TinyTapeout/tt-multiplexer/asw/ihp-sg13cmos5l/README.md

Tiny Tapeout Analog Switches for IHP SG13CMOS5L
===============================================

These are the analog switches that are used to connect/disconnect projects
from the analog pins.

* `tt_asw_3v3`: 3V3 rated switch
* `tt_ckt_ana`: Macro used to attach internal signals to analog pads

Design and layouts were done by Sylvain Munaut.
