TinyTapeout/tt-multiplexer/pg/ihp-sg13cmos5l/README.md

Tiny Tapeout Power Gates for IHP SG13CMOS5L
===========================================

* `tt_pg_1v5_hp_1`: Single height 1.5V switch (high-performance variant)
* `tt_pg_1v5_hp_2`: Dual   height 1.5V switch (high-performance variant)
* `tt_pg_1v5_hp_4`: Quad   height 1.5V switch (high-performance variant)
* `tt_pg_1v5_ll_1`: Single height 1.5V switch (low-leakage variant)
* `tt_pg_1v5_ll_2`: Dual   height 1.5V switch (low-leakage variant)
* `tt_pg_1v5_ll_4`: Quad   height 1.5V switch (low-leakage variant)
* `tt_pg_3v3_2`: Dual height 3.3V switch

Design and layouts were done by Sylvain Munaut.
