TinyTapeout/tt-multiplexer/(threads)

Thread 1 (2023-01-26):

controller / enable testing

jeremybirch, 2023-01-26:
As we have no manufacturing testing of these chips, particularly the user portion, it would be useful to at least be able to show that the enable shift chain is working as expected.
One simple way to do this would be to bring the end of the shift chain back out to a pad (during reset) so that we can see that if we shift N+1 times (where N is the number of user blocks) that the enable comes out at the right time. That we we would at least have some faith that the shift was working correctly, and would be able to characterise it, etc

smunaut, 2023-01-26:
There is no shift chain whatsoever ...

mattvenn, 2023-01-26:
I don't really understand the way designs are enabled: https://github.com/TinyTapeout/tt03-multiplexer/blob/9000062560129114836de59857dd23912760cbb5/proto/tt_ctrl.v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

smunaut, 2023-01-26:
It's an asynchronous counter.
Depending on the number of pulses, it counts up from 0 to 1023.
Then bit [9:5] are used to decode active row, and bit [4:0] to decode the active colum.
Decoding it done combinatorially.

jeremybirch, 2023-01-26:
Ok - sorry I thought it was shifting on the clock pulses. Any way we can
have visibility on the pins of it decoding so that we know at least that
bit is working?

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

jeremybirch, 2023-01-26:
Alternatively if it is counting pulses / why not just drive those row and
column components in from the pins and latch them on the trailing edge of
reset?!

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

smunaut, 2023-01-26:
This was discussed in the call.

Because then you need an external mux for 10 IO lines which is really annoying to deal with in a lot of cases depending on what you want to connect there.

An external uC can take care of sending the pulse with no problem.
Or if the caravel uC works, it can fulfill that function itself simply with 3 external straps ( and I took care to make an easy to strap pinout)

jeremybirch, 2023-01-27:
Ok how about use 1 extra pin and shift in the row and column bits ie takes
around 16 cycles rather than 200+ and eliminates the decode?

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

jeremybirch, 2023-01-27:
an advantage of this is that with  few extra bits in the shift chain you could also configure the IO’s for the given design (ie saying which of the bidirectional pins are configures to input/output/inout) rather than having that as a bus that has to run to every user design. Possibly less flexible than having each of the bidi pins individually configurable from every design on the fly, but I think a lot simpler and demands less wiring resource. Any other configuration specific to the design could also be done this way

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

WallieEverest, 2023-01-31:
Would someone confirm there are 37 MPRJ_IO pins to work with? It seems we have a few unexplored options. A simple solution would be best. We have student users.
Somewhat related topic: Which of the +1.8V power domains connect to our TT2 projects? VCCHIB, VCCD, VCCD1, or VCCD2? Can we isolate the RISC-V and/or the selection logic from the projects? Will the remaining chip work if user space is powered off?

mattvenn, 2023-02-03:
Yes, but as mentioned in the other issue, not all are easily usable.
Yes we're trying for simplicity and ensuring it works.
I can never remember the power domains, take a look at the caravel datasheet. We'll be using the first digital supply domain.

Closed 2023-05-29.

Thread 3 (2023-01-31):

Mux encoder on dev board

WallieEverest, 2023-01-31:
If we do decide on a serialized select method, perhaps we can implement an encoder into the development board?

(I still prefer a combinatorial selection. We just reduce user input size to io_in(10:0) )

mattvenn, 2023-02-03:
If caravel works, then we can use that to select designs and have a default / selection method.
If not then we'll have a co-processor that sits on the board and does the selection.

Closed 2023-05-29.

Thread 5 (2023-06-03):

PDN rails set manually

smunaut, 2023-06-03:
The formula for block / mux height is slightly off causing the planned rails to not fit.
Fixed manually for now, but :
(1) formula fix
(2) properly derive met5 rails params from config

(not done now because this would cause issue with block changing size for 3p5)

smunaut, 2023-07-26:
Fixed.

Closed 2023-07-26.

Thread 7 (2023-07-26):

Ensure no nets can float

smunaut, 2023-07-26:
We need fallback drivers in case no drivers are selected to prevent anything from floating. On both the H/V spines.

urish, 2023-07-26:
What happens if we don't address this?

urish, 2023-09-12:
Answer: when no design is selected, the state of the bidirectional / output pins is undefined.

urish, 2023-10-24:
Can we close this now?

Closed 2023-10-24.

Thread 14 (2024-11-07):

Schematic link for tt_asw_1v8 is wrong

FangameEmpire, 2024-11-07:
The schematic viewer URL points to
`https://github.com/TinyTapeout/tt-multiplexer/blob/main/tt_asw_1v8/xschem/tt_asw_1v8.sch`
when it should point to
`https://github.com/TinyTapeout/tt-multiplexer/blob/main/asw/tt_asw_1v8/xschem/tt_asw_1v8.sch`

The 3.3V version works though.

urish, 2024-11-07:
Thanks for reporting! where is it linked from?

FangameEmpire, 2024-11-15:
The link is at the top of https://github.com/TinyTapeout/tt-multiplexer/blob/main/asw/tt_asw_1v8/README.md

Closed 2024-12-09.
