TinyTapeout/tt-multiplexer/ol2/tt_top/odb_route.py

#
# OpenDB script for custom IO routing for tt_top / user_project_wrapper
#
# Copyright (c) 2023 Sylvain Munaut <tnt@246tNt.com>
# SPDX-License-Identifier: Apache-2.0
#

import os
import sys
import yaml
from collections import namedtuple

import odb

sys.path.append('../../py')
import tt
import tt_odb

import click

from reader import click_odb


def getOtherITermsOnNet(it):
	return [x for x in it.getNet().getITerms() if x.this != it.this]


def load_route_data(tti):
	fn = f'route_data_{tti.cfg.pdk.name}_{tti.cfg.pdk.die.width.nm:d}_{tti.cfg.pdk.die.height.nm:d}.yaml'
	return yaml.load(open(fn), yaml.FullLoader)


class Router:

	def __init__(self, reader, tti):
		# Save vars
		self.reader = reader
		self.tti    = tti

		# Find useful data
		tech = reader.db.getTech()

		self.layer_h = tech.findLayer('Metal3')
		self.layer_v = tech.findLayer('Metal4')
		self.via     = tech.findVia('Via3_XY')

		self.x_spine = []
		self.y_muxes = {}

	def route_vspine_net(self, net):
		# Find extents as well as Y mux pos and X spine pos
		x_min   = None
		x_max   = None

		y_min   = None
		y_max   = None

		x_spine = None
		y_mux   = dict()
		y_ctrl  = [None, None]

		for it in net.getITerms():
			# Get coordinates
			r, x, y = it.getAvgXY()
			if r is not True:
				continue

			# Collect the extent
			if (y_min is None) or (y < y_min):
				y_min = y

			if (y_max is None) or (y > y_max):
				y_max = y

			name = it.getInst().getName()
			if 'ctrl_I' in name:
				x_spine = x
				self.x_spine.append(x)
			else:
				y_mux.setdefault(y, []).append(x)
				self.y_muxes.setdefault(name, (x, []))[1].append(y)

		# Create wire and matching encoder
		wire = odb.dbWire.create(net)

		encoder = odb.dbWireEncoder()
		encoder.begin(wire)

		# Create vertical spine
		encoder.newPath(self.layer_v, 'FIXED')
		encoder.addPoint(x_spine, y_min)
		encoder.addPoint(x_spine, y_max)

		# Create horizontal link for each mux
		for y,xl in y_mux.items():
			xl.append(x_spine)
			x_min_l = min(xl)
			x_max_l = max(xl)

			encoder.newPath(self.layer_h, 'FIXED')
			if x_min_l < x_spine:
				encoder.addPoint(x_min_l, y)
			encoder.addPoint(x_spine, y)
			if x_max_l > x_spine:
				encoder.addPoint(x_max_l, y)

			encoder.newPath(self.layer_v, 'FIXED')
			encoder.addPoint(x_spine, y)
			encoder.addTechVia(self.via)

		encoder.end()

	def route_vspine(self):
		# Find controller
		ctrl_inst = self.reader.block.findInst('top_I.ctrl_I')

		# Route each spine net
		for i in range(self.tti.layout.vspine.iw):
			self.route_vspine_net(ctrl_inst.findITerm(f'spine_bot_iw[{i:d}]').getNet())
			self.route_vspine_net(ctrl_inst.findITerm(f'spine_top_iw[{i:d}]').getNet())

		for i in range(self.tti.layout.vspine.ow):
			self.route_vspine_net(ctrl_inst.findITerm(f'spine_bot_ow[{i:d}]').getNet())
			self.route_vspine_net(ctrl_inst.findITerm(f'spine_top_ow[{i:d}]').getNet())

	def create_spine_obs(self):
		# Find top/bottom
		y_min = min(sum([yl for xl,yl in self.y_muxes.values()], []))
		y_max = max(sum([yl for xl,yl in self.y_muxes.values()], []))

		# Create vspine obstruction
		x_min_spine = min(self.x_spine)
		x_max_spine = max(self.x_spine)

		odb.dbObstruction_create(self.reader.block,
			self.layer_v,
			x_min_spine, y_min,
			x_max_spine, y_max,
		)

		# Create horizontal link obstruction for each mux
		for k, v in self.y_muxes.items():
			x_min_hlink = min([v[0], x_min_spine])
			x_max_hlink = max([v[0], x_max_spine])
			y_min_hlink = min(v[1])
			y_max_hlink = max(v[1])

			odb.dbObstruction_create(self.reader.block,
				self.layer_h,
				x_min_hlink, y_min_hlink,
				x_max_hlink, y_max_hlink,
			)

	def create_macro_obs(self):
		# Get all layers
		tech = self.reader.db.getTech()

		layers = [
			tech.findLayer(ln)
				for ln in
					self.tti.cfg.pdk.tracks._cfg.keys()
		]

		# Iterate over all macros
		for inst in self.reader.instances:
			bb = inst.getBBox()
			for l in layers:
				odb.dbObstruction_create(self.reader.block,
					l,
					bb.xMin() + self.tti.layout.glb.margin.x,
					bb.yMin() + self.tti.layout.glb.margin.y,
					bb.xMax() - self.tti.layout.glb.margin.x,
					bb.yMax() - self.tti.layout.glb.margin.y,
				)

	def route_pad(self):
		# Vias
		tech = self.reader.db.getTech()
		via3yx = tech.findVia('Via3_YX')
		via3xy = tech.findVia('Via3_XY')

		# Find controller instance
		ctrl_inst = self.reader.block.findInst('top_I.ctrl_I')

		# Load data file
		data = load_route_data(self.tti)['ports']

		# Iterate through data file
		for port_name, rpts in data.items():
			# Starting point
			it = ctrl_inst.findITerm(port_name)
			sx, sy = it.getAvgXY()[1:]
			sl = it.getGeometries()[0][0]

			# Net / Wire
			net = it.getNet()
			wire = odb.dbWire.create(net)

			# Ending point
			it_other = getOtherITermsOnNet(it)[0]
			e_rect = [rect for ly, rect in it_other.getGeometries() if ly.getName() == 'Metal3'][0]
			ex = e_rect.xCenter()
			ey = e_rect.yCenter()

			# Prepare path
			if len(rpts) == 1:
				rpts = [
					( rpts[0], None ),
					( ex, via3yx ),
					( ey, None ),
				]

			elif len(rpts) == 2:
				rpts = [
					( rpts[0], via3xy ),
					( rpts[1], via3xy ),
					( ey, via3xy ),
					( ex, None ),
				]

			else:
				raise RuntimeError('Invalid path')

			# Encoder start
			encoder = odb.dbWireEncoder()
			encoder.begin(wire)

			encoder.newPath(sl, 'FIXED')
			encoder.addPoint(sx, sy)

			# Scan through routing points
			px = sx
			py = sy
			xy = True

			for pt, vt in rpts:
				# Next point
				if xy:
					py = pt
				else:
					px = pt

				encoder.addPoint(px, py)

				# Toggle routing direction
				xy ^= True

				# Add via
				if vt is not None:
					encoder.addTechVia(vt)

			# Encoder end
			encoder.end()

	def route_um_tieoffs(self):
		# Get track info
		# We route horizontally on Metal4, non-preferred direction ...
		track_cfg = self.tti.cfg.pdk.tracks.Metal4.y

		def track_align(v):
			return track_cfg.offset + ((v - track_cfg.offset) // track_cfg.pitch) * track_cfg.pitch

		# Scan all the muxes
		for inst in self.reader.instances:
			# Not a mux -> skip
			if inst.getMaster().getName() != 'tt_mux':
				continue

			# Instance bounding box
			inst_bbox = inst.getBBox()
			inst_y_mid = ( inst_bbox.yMin() + inst_bbox.yMax() ) // 2

			# Scan all um_k_zero[]
			for k0_it in inst.getITerms():
				# Not right port ?
				if not k0_it.getMTerm().getName().startswith('um_k_zero'):
					continue

				# Get net and check if there are anything to tie
				k0_net = k0_it.getNet()
				if k0_net.getITermCount() <= 1:
					continue

				# Get layer
				layer = k0_it.getMTerm().getMPins()[0].getGeometry()[0].getTechLayer()

				# Get strap Y position
				sy = k0_it.getAvgXY()[2]

				if sy > inst_y_mid:
					sy = track_align(inst_bbox.yMax() + track_cfg.width + track_cfg.pitch - 1)
				else:
					sy = track_align(inst_bbox.yMin() - track_cfg.width)

				# Start custom routing
				wire = odb.dbWire.create(k0_net)

				encoder = odb.dbWireEncoder()
				encoder.begin(wire)

				# Collect all ITerms positions
				it_pos = [ it.getAvgXY()[1:] for it in k0_net.getITerms() ]
				it_pos.sort()

				encoder.newPath(layer, 'FIXED')

				for n, (px, py) in enumerate(it_pos):
					if n == 0:
						encoder.addPoint(px, py)
						encoder.addPoint(px, sy)
						continue
					elif n > 1:
						encoder.newPath(j)
					j = encoder.addPoint(px, sy)
					encoder.addPoint(px, py)

				# End routing
				encoder.end()

	def route_um_signals(self):
		# Get via
		tech = self.reader.db.getTech()
		via = tech.findVia('Via4_YY')

		# Scan all the user modules
		for um_inst in self.reader.instances:
			# Is this a user module ?
			if not um_inst.getName().endswith('.tt_um_I'):
				continue

			# Find matching mux
			ena_net = um_inst.findITerm('ena').getNet()
			for it in ena_net.getITerms():
				if it.getInst().getMaster().getName() == 'tt_mux':
					mux_inst = it.getInst()
					break
			else:
				# WTF couln't find mux ...
				continue

			# Get Y coordinates we need to connect to/from
			mux_bbox = mux_inst.getBBox()
			um_bbox  = um_inst.getBBox()

			if mux_bbox.yMin() > um_bbox.yMax():
				y_um  = um_bbox.yMax()
				y_mux = mux_bbox.yMin()
			else:
				y_um  = um_bbox.yMin()
				y_mux = mux_bbox.yMax()

			# Scan every connection
			for um_it in um_inst.getITerms():
				# Get the net
				net = um_it.getNet()

				# We only care about signals going between user module and
				# the mux and nowhere else
				net_it_lst = net.getITerms()

				if len(net_it_lst) != 2:
					continue

				for it in net_it_lst:
					if it.getInst().getMaster().getName() == 'tt_mux':
						mux_it = it
						break
				else:
					continue

				# We get the x coordinate from the mux since it's the only
				# we can trust
				_, x, _ = mux_it.getAvgXY()

				# Get layer too
				layer_mux = mux_it.getMTerm().getMPins()[0].getGeometry()[0].getTechLayer()
				layer_um  =  um_it.getMTerm().getMPins()[0].getGeometry()[0].getTechLayer()

				# Route the wire
				wire = odb.dbWire.create(net)

				encoder = odb.dbWireEncoder()
				encoder.begin(wire)
				encoder.newPath(layer_mux, 'FIXED')
				encoder.addPoint(x, y_mux)

				if layer_mux.getName() != layer_um.getName():
					encoder.addPoint(x, (y_mux + y_um) // 2)
					encoder.addTechVia(via)

				encoder.addPoint(x, y_um)
				encoder.end()


	def k01_get_track(self, side, idx):
		# Get full die area
		die = self.reader.block.getDieArea()

		# Prepare recording of used tracks if not done already
		if not hasattr(self, 'k01_tracks'):
			self.k01_tracks = {
				'left':  [],
				'right': [],
				'bot':   [],
				'top':   [],
			}

		# Track config
		cfg_tv = self.tti.cfg.pdk.tracks.met4.x
		cfg_th = self.tti.cfg.pdk.tracks.met3.y

		# Alignement function
		def a(cfg, v):
			return cfg.offset + ((v - cfg.offset) // cfg.pitch) * cfg.pitch

		# Return requested track
		if side == 'left':
			t = cfg_tv.offset + cfg_tv.pitch * idx

		elif side == 'right':
			t = a(cfg_tv, die.xMax() - cfg_tv.pitch * idx)

		elif side == 'bot':
			t = cfg_th.offset + cfg_th.pitch * idx

		elif side == 'top':
			t = a(cfg_th, die.yMax() - cfg_th.pitch * idx)

		else:
			# ?!!?
			t = None

		self.k01_tracks[side].append(t)
		return t;

	def route_k01_gpio(self):
		# Get full die area
		die = self.reader.block.getDieArea()

		# Vias
		tech = self.reader.db.getTech()

		via = {
			('met2', 'met3'): tech.findVia('M2M3_PR'),
			('met3', 'met4'): tech.findVia('M3M4_PR'),
		}

		# Scan all BTerm to find gpio_loopback_{zero,one}[]
		for bterm in self.reader.block.getBTerms():
			# Check it's a bterm of interest
			if not bterm.getName().startswith('gpio_loopback'):
				continue

			# Select index
			if 'zero' in bterm.getName():
				idx = 0
			elif 'one' in bterm.getName():
				idx = 1

			# Select side
			bt_bbox = bterm.getBBox()
			if   bt_bbox.xMin() < die.xMin():
				side = 'left'
			elif bt_bbox.xMax() > die.xMax():
				side = 'right'
			elif bt_bbox.yMin() < die.yMin():
				side = 'bot'
			elif bt_bbox.yMax() > die.yMax():
				side = 'top'

			# Get track
			trk = self.k01_get_track(side, idx)

			# Get layer of bterm
			bterm_box = bterm.getBPins()[0].getBoxes()[0]
			bterm_ly  = bterm_box.getTechLayer()

			# Get the coordinates for all other bterms on net
			net = bterm.getNet()

			pos = []

			for bterm_sec in net.getBTerms():
				# Check it's in the same layer
				if bterm_sec.getBPins()[0].getBoxes()[0].getTechLayer().getName() != bterm_ly.getName():
					continue

				# Get position
				pr, px, py = bterm_sec.getFirstPinLocation()
				if pr is not True:
					continue

				# Record it
				pos.append( (px, py) )

			# Create new wire
			wire = odb.dbWire.create(net)

			# Encoder start
			encoder = odb.dbWireEncoder()
			encoder.begin(wire)

			# Draw
			if side in ['left', 'right']:
				# Vertical segment
				encoder.newPath(self.layer_v, 'FIXED')
				encoder.addPoint(trk, min([p[1] for p in pos]))
				encoder.addPoint(trk, max([p[1] for p in pos]))

				# Connect each position
				for px, py in pos:
					encoder.newPath(bterm_ly, 'FIXED')
					encoder.addPoint(px, py)
					encoder.addPoint(trk, py)
					encoder.addTechVia(via[(bterm_ly.getName(), self.layer_v.getName())])

			elif side in ['bot', 'top']:
				# Horizontal segment
				encoder.newPath(self.layer_h, 'FIXED')
				encoder.addPoint(min([p[0] for p in pos]), trk)
				encoder.addPoint(max([p[0] for p in pos]), trk)

				# Connect each position
				for px, py in pos:
					encoder.newPath(bterm_ly, 'FIXED')
					encoder.addPoint(px, py)
					encoder.addPoint(px, trk)
					encoder.addTechVia(via[(bterm_ly.getName(), self.layer_h.getName())])

			# Encoder end
			encoder.end()

	def route_k01_global(self):
		# Vias
		tech = self.reader.db.getTech()

		via = {
			('met2', 'met3'): tech.findVia('M2M3_PR'),
			('met3', 'met4'): tech.findVia('M3M4_PR'),
		}

		# Get full die area
		die = self.reader.block.getDieArea()

		# Find controller instance
		ctrl_inst = self.reader.block.findInst('top_I.ctrl_I')

		# Start index
		idx = 2

		# Deal with each constant
		for port_name in ['k_zero', 'k_one']:
			# ITerm on controller
			ctrl_iterm = ctrl_inst.findITerm(port_name)
			r, x, y = ctrl_iterm.getAvgXY()
			if r is not True:
				continue

			# Get associated net
			net = ctrl_iterm.getNet()

			# Check if there are any users
			if (net is None) or (len(net.getBTerms()) == 0):
				continue

			# Limits
			lx = [
				self.k01_get_track('left', idx),
				self.k01_get_track('right', idx),
			]

			ly = [
				self.k01_get_track('bot', idx),
				self.k01_get_track('top', idx),
			]

			idx += 1

			# Create new wire
			wire = odb.dbWire.create(net)

			# Encoder start
			encoder = odb.dbWireEncoder()
			encoder.begin(wire)

			# Line toward bottom
			encoder.newPath(self.layer_v, 'FIXED')
			encoder.addPoint(x, y)
			encoder.addPoint(x, ly[0])
			encoder.addTechVia(self.via)
			encoder.addPoint(lx[1], ly[0])
			encoder.addTechVia(self.via)
			encoder.addPoint(lx[1], ly[1])
			encoder.addTechVia(self.via)
			encoder.addPoint(lx[0], ly[1])
			encoder.addTechVia(self.via)
			encoder.addPoint(lx[0], ly[0])
			encoder.addTechVia(self.via)
			encoder.addPoint(x, ly[0])

			# Iterate over all BTerms
			for pad_bterm in net.getBTerms():
				# Get pin location / Bounding Box
				pr, px, py = pad_bterm.getFirstPinLocation()
				if pr is not True:
					continue

				pad_bb  = pad_bterm.getBBox()
				pad_box = pad_bterm.getBPins()[0].getBoxes()[0]
				pad_ly  = pad_box.getTechLayer()

				# Start path
				encoder.newPath(pad_ly, 'FIXED')
				encoder.addPoint(px, py)

				# Check side
				if pad_bb.yMin() < 0:				# Bottom
					encoder.addPoint(px, ly[0])
					encoder.addTechVia(via[(pad_ly.getName(), self.layer_h.getName())])

				elif pad_bb.yMax() > die.yMax():	# Top
					encoder.addPoint(px, ly[1])
					encoder.addTechVia(via[(pad_ly.getName(), self.layer_h.getName())])

				elif pad_bb.xMin() < 0:				# Left
					encoder.addPoint(lx[0], py)
					encoder.addTechVia(via[(pad_ly.getName(), self.layer_v.getName())])

				elif pad_bb.xMax() > die.xMax():	# Right
					encoder.addPoint(lx[1], py)
					encoder.addTechVia(via[(pad_ly.getName(), self.layer_v.getName())])

				else:
					# ?!?!?
					continue

			# Encoder end
			encoder.end()

	def create_k01_obs(self):

		# No tracks ?
		if not hasattr(self, 'k01_tracks'):
			return

		# Get all layers and config
		tech = self.reader.db.getTech()

		layer_v = tech.findLayer('met4')
		layer_h = tech.findLayer('met3')

		cfg_v = self.tti.cfg.pdk.tracks.met4.x
		cfg_h = self.tti.cfg.pdk.tracks.met3.y

		die = self.reader.block.getDieArea()

		# Limits
		if self.k01_tracks['left']:
			lx_left = [
				min(self.k01_tracks['left']) - cfg_v.pitch // 2,
				max(self.k01_tracks['left']) + cfg_v.pitch // 2,
			]
		else:
			lx_left = [ die.xMin(), die.xMin() ]

		if self.k01_tracks['right']:
			lx_right = [
				min(self.k01_tracks['right']) - cfg_v.pitch // 2,
				max(self.k01_tracks['right']) + cfg_v.pitch // 2,
			]
		else:
			lx_right = [ die.xMax(), die.xMax() ]

		if self.k01_tracks['bot']:
			ly_bot = [
				min(self.k01_tracks['bot']) - cfg_h.pitch // 2,
				max(self.k01_tracks['bot']) + cfg_h.pitch // 2,
			]
		else:
			ly_bot = [ die.yMin(), die.yMin() ]

		if self.k01_tracks['top']:
			ly_top = [
				min(self.k01_tracks['top']) - cfg_h.pitch // 2,
				max(self.k01_tracks['top']) + cfg_h.pitch // 2,
			]
		else:
			ly_top = [ die.yMax(), die.yMax() ]

		# Left
		if self.k01_tracks['left']:
			odb.dbObstruction_create(self.reader.block,
				layer_v, lx_left[0], ly_bot[0], lx_left[1], ly_top[1])

		# Right
		if self.k01_tracks['right']:
			odb.dbObstruction_create(self.reader.block,
				layer_v, lx_right[0], ly_bot[0], lx_right[1], ly_top[1])

		# Bottom
		if self.k01_tracks['bot']:
			odb.dbObstruction_create(self.reader.block,
				layer_h, lx_left[0], ly_bot[0], lx_right[1], ly_bot[1])

		# Top
		if self.k01_tracks['top']:
			odb.dbObstruction_create(self.reader.block,
				layer_h, lx_left[0], ly_top[0], lx_right[1], ly_top[1])



class ViaGenerator:

	def __init__(self, reader, via_rule_name):
		# No known via
		self.vias = {}

		# Save interesting vars
		self.reader = reader
		self.tech = tech = reader.db.getTech()

		# Find Via Rule
		self.via_rule = tech.findViaGenerateRule(via_rule_name)

		# Identify rules for top/cut/bot
		met = []

		for i in range(self.via_rule.getViaLayerRuleCount()):
			ly_rule = self.via_rule.getViaLayerRule(i)
			ly = ly_rule.getLayer()

			# Is it the cut ?
			if ly.getType() == 'CUT':
				self.cut_ly  = ly
				self.cut_sz  = [ ly_rule.getRect().dx(), ly_rule.getRect().dy() ]
				self.cut_spc = ly_rule.getSpacing()

				# The cut spacing in the rule is center to center
				# but when creating the via we need it border to border ?!?!
				self.cut_spc[0] -= self.cut_sz[0]
				self.cut_spc[1] -= self.cut_sz[1]

			# Or Metal ?
			elif ly.getType() == 'ROUTING':
				enc = ly_rule.getEnclosure()
				met.append( (ly.getName(), ly, enc) )

			# WTF ?
			else:
				raise RuntimeError('Unknown via rule')

		met = sorted(met)

		self.bot_ly  = met[0][1]
		self.bot_enc = met[0][2]

		self.top_ly  = met[1][1]
		self.top_enc = met[1][2]

	def create(self, ncols, nrows, name=None):
		# Create via
		if name is None:
			name = f'vg_{(hash(self) & 0xffffffff):08x}_{ncols:d}x{nrows:d}'

		v = odb.dbVia.create(self.reader.block, name)
		v.setViaGenerateRule(self.via_rule)

		# Configure params
		vp = v.getViaParams()

		vp.setBottomLayer(self.bot_ly)
		vp.setCutLayer(self.cut_ly)
		vp.setTopLayer(self.top_ly)
		vp.setNumCutCols(ncols)
		vp.setNumCutRows(nrows)
		vp.setXCutSize(self.cut_sz[0])
		vp.setYCutSize(self.cut_sz[1])
		vp.setXCutSpacing(self.cut_spc[0])
		vp.setYCutSpacing(self.cut_spc[1])
		vp.setXBottomEnclosure(self.bot_enc[0])
		vp.setYBottomEnclosure(self.bot_enc[1])
		vp.setXTopEnclosure(self.top_enc[0])
		vp.setYTopEnclosure(self.top_enc[1])

		v.setViaParams(vp)

		# Done
		return v

	def get(self, ncols, nrows):
		k = (ncols, nrows)
		if k not in self.vias:
			self.vias[k] = self.create(ncols, nrows)
		return self.vias[k]

	def get4sz(self, vw, vh):
		# Compute row / columns
		ncols = (vw // (self.cut_sz[0] + self.cut_spc[0])) - 1
		nrows = (vh // (self.cut_sz[1] + self.cut_spc[1])) - 1
		return self.get(ncols, nrows)

	def get4sz_ext(self, vw, vh, bot_fit='xy', top_fit='xy'):
		# Constraints
		ncols = []
		nrows = []

		if 'x' in bot_fit:
			ncols.append( (vw - 2 * self.bot_enc[0] + self.cut_spc[0]) // (self.cut_sz[0] + self.cut_spc[0]) )

		if 'x' in top_fit:
			ncols.append( (vw - 2 * self.top_enc[0] + self.cut_spc[0]) // (self.cut_sz[0] + self.cut_spc[0]) )

		if 'y' in bot_fit:
			nrows.append( (vh - 2 * self.bot_enc[1] + self.cut_spc[1]) // (self.cut_sz[1] + self.cut_spc[1]) )

		if 'y' in top_fit:
			nrows.append( (vh - 2 * self.top_enc[1] + self.cut_spc[1]) // (self.cut_sz[1] + self.cut_spc[1]) )

		ncols = min(ncols)
		nrows = min(nrows)

		# Safety check
		if (ncols <= 0) or (nrows <= 0):
			return None

		# Get final via
		return self.get(ncols, nrows)



class ModulePowerPadData(namedtuple('ModulePowerPadData', 'xc xw yb yt')):

	__slots__ = []

	@classmethod
	def from_geometry(kls, g, grid=1):
		xc = ((g.xMin() + g.xMax()) // (2 * grid)) * grid
		xw = min(g.xMax() - xc, xc - g.xMin()) * 2
		return kls(xc, xw, g.yMin(), g.yMax())


class ModulePowerStrapper:

	def __init__(self, reader, tti):
		# Save vars
		self.reader = reader
		self.tti    = tti

		# Find useful data
		tech = reader.db.getTech()

		self.vg = ViaGenerator(self.reader, 'viaTop1Array')
		self.layer = tech.findLayer('TopMetal1')

		self.stripe_space, self.stripe_width = self._find_stripe_space_width()
		self.space = 3000
		self.grid = tech.getManufacturingGrid()

	def _grid_align(self, v):
		return (v // self.grid) * self.grid

	def _find_stripe_space_width(self):
		# Get all `met5` stripes for VGND
		net = self.reader.block.findNet('vgnd')
		sw = net.getSWires()[0]
		stripes = [
			w for w in sw.getWires() if (
				not w.isVia() and
				w.getTechLayer().getName() == 'TopMetal1' and
				w.getWireShapeType() == 'STRIPE'
			)
		]

		# Get spacing and width
		yl = sorted([x.yMin() for x in stripes])

		return (yl[1] - yl[0]), stripes[0].getDY()

	def _get_y_pos_width(self, pg_inst, pg_idx, pg_cnt):
		# Is it single or double height ?
		h = int(pg_inst.getMaster().getName()[-1])

		# Get switch physical dimensions
		bbox = pg_inst.getBBox()

		y_min = bbox.yMin()
		y_max = bbox.yMax()
		y_mid = (y_min + y_max) // 2

		# If we only have one power strap, allocate all to it
		if pg_cnt == 1:
			# Wide strip
			w = 2 * self.stripe_width + self.space

			# Select depending on height
			if h == 1:
				return [ ( y_mid, w ) ]

			elif h == 2:
				return [
					( y_mid + self.stripe_space, w ),
					( y_mid,                     w ),
					( y_mid - self.stripe_space, w ),
				]

			elif h == 4:
				spc = self.stripe_space // 2
				return [
					( y_mid + spc * 7, w ),
					( y_mid + spc * 5, w ),
					( y_mid + spc * 3, w ),
					( y_mid + spc * 1, w ),
					( y_mid - spc * 1, w ),
					( y_mid - spc * 3, w ),
					( y_mid - spc * 5, w ),
					( y_mid - spc * 7, w ),
				]

			else:
				raise RuntimeError('Unsupported heigh Power Gate')

		# If we have two, then the center one is split
		elif pg_cnt == 2:
			# Wide and narrow stripes + offset
			ww = 2 * self.stripe_width + self.space
			wn = self.stripe_width

			ofs1 = (1 - 2*pg_idx) * ((self.stripe_width + self.space) // 2)
			ofs2 = (2*pg_idx - 1) * self.stripe_space

			# Select depending on height
			if h == 1:
				return [ ( y_mid + ofs1, wn ) ]

			elif h == 2:
				return [
					( y_mid + ofs1, wn ),
					( y_mid + ofs2, ww ),
				]

			else:
				raise RuntimeError('Unsupported heigh Power Gate')

		# Huh ?
		else:
			raise RuntimeError('Unsupported number of Power Gates')


	def _get_pad_data(self, um_it, pg_it):
		# Find geometry for those terminals
		geom_um = [ x[1] for x in pg_it.getGeometries() ]
		geom_pg = [ x[1] for x in um_it.getGeometries() ]
		geom = geom_um + geom_pg

		# Extent ( + extra for worse case enclosure requirement )
		xl = min([x.xMin() for x in geom]) - self.vg.top_enc[0]
		xr = max([x.xMax() for x in geom]) + self.vg.top_enc[0]

		# Center positions and width
		pd = [ModulePowerPadData.from_geometry(g, grid=self.grid) for g in geom]

		# Attempt to merge contiguous pads
		pd.sort(key=lambda x: (x.xc, x.yb))

		pd_merged = []
		pad_cur = pd[0]

		for pad_nxt in pd[1:]:
			if pad_cur.xc == pad_nxt.xc and pad_cur.xw == pad_nxt.xw and pad_cur.yt >= pad_nxt.yb:
				# Merge
				pad_cur = ModulePowerPadData(pad_cur.xc, pad_cur.xw, pad_cur.yb, max(pad_cur.yt, pad_nxt.yt))
			else:
				# Discontinuous
				pd_merged.append(pad_cur)
				pad_cur = pad_nxt

		pd_merged.append(pad_cur)

		# Return result
		return xl, xr, pd_merged

	def _draw_stripe(self, sw, yp, yw, xl, xr, pd):
		# Stripe
		odb.createSBoxes(sw, self.layer, [odb.Rect(xl, yp-yw//2, xr, yp+yw//2)], "STRIPE")

		# Vias
		for pad in pd:
			# Default via param
			vx = pad.xc
			vy = yp
			vw = pad.xw
			vh = yw
			bot_fit = 'x'

			# Validate extent of pad (with ample argin for enclosure)
			if ((yp - yw * 0.55) < pad.yb) or ((yp + yw * 0.55) > pad.yt):
				# Doesn't fully fit, so be more restrictive
				bot_fit = 'xy'

				y_bot = max(pad.yb, yp - yw // 2)
				y_top = min(pad.yt, yp + yw // 2)

				vy = self._grid_align((y_top + y_bot) // 2)
				vh = min(y_top - vy, vy - y_bot) * 2

			# Get matching via
			via = self.vg.get4sz_ext(vw, vh, top_fit='y', bot_fit=bot_fit)
			if via is None:
				continue

			# Add it
			odb.createSBoxes(sw, via, [odb.Point(vx, vy)], "STRIPE")

	def run(self):

		# Find all user modules
		for um_inst in self.reader.block.getInsts():
			# Is it a user module ?
			if not um_inst.getName().endswith('.tt_um_I'):
				continue

			# Find power ITerms with power gate
			pg_list = []

			for um_it in um_inst.getITerms():
				# Power ?
				if not um_it.getSigType() == 'POWER':
					continue

				# Check if it's on a power gate
				if um_it.getNet().getITermCount() != 2:
					continue

				pg_it = getOtherITermsOnNet(um_it)[0]

				# Record
				pg_list.append( (um_it, pg_it) )

			# Connect each
			pg_cnt = len(pg_list)

			for pg_idx, (um_it, pg_it) in enumerate(pg_list):
				# Power gate instance
				pg_inst = pg_it.getInst()

				# Pick appropriate Y positions for straps
				ypw = self._get_y_pos_width(pg_inst, pg_idx, pg_cnt)

				# Get the X data (extent + via pos)
				xl, xr, pd = self._get_pad_data(um_it, pg_it)

				# Find net and create the matching special wire
				net = um_it.getNet()
				sw = odb.dbSWire.create(net, "ROUTED")

				# Draw for each y position
				for yp, yw in ypw:
					self._draw_stripe(sw, yp, yw, xl, xr, pd)


class RingPowerStrapper:

	def __init__(self, reader):
		# Save vars
		self.reader = reader

		# Find useful data
		self.tech = tech = reader.db.getTech()

		self.layers = {
			2: tech.findLayer('Metal2'),
			3: tech.findLayer('Metal3'),
			4: tech.findLayer('Metal4'),
		}
		self.viagen = {
			(2,3): ViaGenerator(reader, 'via2Array'),
			(3,4): ViaGenerator(reader, 'via3Array'),
		}

	def find_ring_for_net(self, net):
		# Find all the boxes on met4
		boxes = []
		for sw in net.getSWires():
			for w in sw.getWires():
				# Skip vias
				if w.isVia():
					continue

				# Only ring
				if w.getWireShapeType() != 'RING':
					continue

				boxes.append(w)

		# There should be none or 4
		if len(boxes) == 0:
			return None

		if len(boxes) != 4:
			raise RuntimeError(f'Unexpected boxes for net {net.getName():s}')

		# Sort and return
		boxes_ver = sorted([b for b in boxes if b.getDX() < b.getDY()], key=lambda x:x.xMin())
		boxes_hor = sorted([b for b in boxes if b.getDX() > b.getDY()], key=lambda x:x.yMin())

		return {
			'l': boxes_ver[0],
			'r': boxes_ver[1],
			'b': boxes_hor[0],
			't': boxes_hor[1],
		}

	def complete_ring(self, net, ring):
		sw = odb.dbSWire.create(net, "ROUTED")
		for box in [ ring['b'], ring['t'] ]:
			odb.createSBoxes(sw, self.tech.findLayer('Metal4'), [odb.Rect(box.xMin(), box.yMin(), box.xMax(), box.yMax())], "RING")

	def strap_draw_lr(self, sw, sxl, sxr, rxl, rxr, yb, yt):
		# Metal2 Stripe
		odb.createSBoxes(sw, self.layers[2], [odb.Rect(sxl, yb, sxr, yt)], "STRIPE")

		# Metal3 "Intermediate"
		odb.createSBoxes(sw, self.layers[3], [odb.Rect(rxl, yb, rxr, yt)], "STRIPE")

		# Connecting vias
		via23 = self.viagen[(2,3)].get4sz(rxr-rxl, yt-yb)
		via34 = self.viagen[(3,4)].get4sz(rxr-rxl, yt-yb)

		rxm = (rxl + rxr) // 2
		ym  = ( yb +  yt) // 2
		odb.createSBoxes(sw, via23, [odb.Point(rxm, ym)], "STRIPE")
		odb.createSBoxes(sw, via34, [odb.Point(rxm, ym)], "STRIPE")

	def strap_draw_tb(self, sw, xl, xr, syb, syt, ryb, ryt):
		# Metal2 Stripe
		odb.createSBoxes(sw, self.layers[2], [odb.Rect(xl, syb, xr, syt)], "STRIPE")

		# Metal3 "Intermediate"
		odb.createSBoxes(sw, self.layers[3], [odb.Rect(xl, ryb, xr, ryt)], "STRIPE")

		# Connecting vias
		via23 = self.viagen[(2,3)].get4sz(xr-xl, ryt-ryb)
		via34 = self.viagen[(3,4)].get4sz(xr-xl, ryt-ryb)

		xm  = ( xl +  xr) // 2
		rym = (ryb + ryt) // 2
		odb.createSBoxes(sw, via23, [odb.Point(xm, rym)], "STRIPE")
		odb.createSBoxes(sw, via34, [odb.Point(xm, rym)], "STRIPE")

	def strap_iterm(self, net, ring, sw, iterm):
		# Core area
		core = self.reader.block.getCoreArea()

		# Scan all the geometries for that ITerm
		for ly, rect in iterm.getGeometries():
			# All power pins connections are expected to be on Metal2
			if ly.getName() != 'Metal2':
				continue

			# Get instance bbox
			ibb = iterm.getInst().getBBox()

			# Which side is the pin on ?
			if rect.xMax() < core.xMin():		# Left
				# Check geometry is on right side of the pad
				if ibb.xMax() != rect.xMax():
					continue

				# Create new SWire for our straps if needed
				if sw is None:
					sw = odb.dbSWire.create(net, "ROUTED")

				# Draw strap
				self.strap_draw_lr(sw,
					rect.xMax(),      ring['l'].xMax(),
					ring['l'].xMin(), ring['l'].xMax(),
					rect.yMin(),      rect.yMax()
				)

			elif rect.xMin() > core.xMax():		# Right
				# Check geometry is on left side of the pad
				if ibb.xMin() != rect.xMin():
					continue

				# Create new SWire for our straps if needed
				if sw is None:
					sw = odb.dbSWire.create(net, "ROUTED")

				# Draw strap
				self.strap_draw_lr(sw,
					ring['r'].xMin(), rect.xMin(),
					ring['r'].xMin(), ring['r'].xMax(),
					rect.yMin(),      rect.yMax()
				)

			elif rect.yMax() < core.yMin():		# Bottom
				# Check geometry is on top side of the pad
				if ibb.yMax() != rect.yMax():
					continue

				# Create new SWire for our straps if needed
				if sw is None:
					sw = odb.dbSWire.create(net, "ROUTED")

				# Draw strap
				self.strap_draw_tb(sw,
					rect.xMin(),      rect.xMax(),
					rect.yMax(),      ring['b'].yMax(),
					ring['b'].yMin(), ring['b'].yMax(),
				)

			elif rect.yMin() > core.yMax():		# Top
				# Check geometry is on bottom side of the pad
				if ibb.yMin() != rect.yMin():
					continue

				# Create new SWire for our straps if needed
				if sw is None:
					sw = odb.dbSWire.create(net, "ROUTED")

				# Draw strap
				self.strap_draw_tb(sw,
					rect.xMin(),      rect.xMax(),
					ring['t'].yMin(), rect.yMin(),
					ring['t'].yMin(), ring['t'].yMax(),
				)

			else:
				# ???
				continue

		return sw

	def strap_net(self, net):
		# Find all the rings boxes
		ring = self.find_ring_for_net(net)
		if ring is None:
			return

		# Complete the ring with Metal4 on top/bottom
		#self.complete_ring(net, ring)

		# Don't create SWire if not needed
		sw = None

		# Find all the ITerms
		for iterm in net.getITerms():
			# Check it's a pad
			if not iterm.getInst().getName().endswith('.pad_I'):
				continue
			if not iterm.getInst().getName().startswith('gpio'):
				continue

			# Connect it
			sw = self.strap_iterm(net, ring, sw, iterm)

	def run(self):
		# Scan all power nets and check if they need strapping
		for net in self.reader.block.getNets():
			if net.getSigType() in ['POWER', 'GROUND']:
				self.strap_net(net)


class AnalogRouter:

	def __init__(self, reader, tti):
		# Save vars
		self.reader = reader
		self.tti    = tti

		# Create tech rules
		self.prepare_tech()

		# Find all analog switches
		self.asw = [
			inst
				for inst in self.reader.block.getInsts()
				if inst.getMaster().getName().startswith('tt_asw')
		]

		# Load route data file
		self.route_data = load_route_data(tti).get('analog', {})

	def prepare_tech(self):
		# Find tech and layers
		tech = self.reader.db.getTech()
		self.layer_bot = tech.findLayer('Metal3')
		self.layer_top = tech.findLayer('Metal4')
		self.via_sig   = tech.findVia('Via3_XY')

		# Create via for analog signal
		viagen = ViaGenerator(self.reader, 'via3Array')
		self.via = viagen.create(6, 6, 'analog_via')

		# Create via generator for power
		self.pwr_vg = ViaGenerator(self.reader, 'viaTop1Array')

		# Create non-default rule
		self.ndr = ndr = odb.dbTechNonDefaultRule_create(self.reader.block, 'analog_track')
		for ln in [ 'Metal1', 'Metal2', 'Metal3', 'Metal4', 'TopMetal1' ]:
			ly = tech.findLayer(ln)
			lr = odb.dbTechLayerRule_create(ndr, ly)
			lr.setWidth(tt.LayoutDimension(3000).iu)
			lr.setSpacing(tt.LayoutDimension(2000).iu)

	def _asw_find_pdn_stripe(self, net, y, above):
		# Scan all special wires on that net
		best_sb   = None
		best_dist = None

		for sw in net.getSWires():
			for sb in sw.getWires():
				# Must be horizontal non-via STRIPE
				if sb.isVia() or (sb.getWireShapeType() != 'STRIPE') or (sb.getDY() > sb.getDX()):
					continue

				# Distance
				d = ((sb.yMin() + sb.yMax()) // 2) - y

				if above ^ (d > 0):
					continue

				if (best_dist is None) or (abs(d) < abs(best_dist)):
					best_sb   = sb
					best_dist = d

		# Return result
		center = (best_sb.yMin() + best_sb.yMax()) // 2
		farend = best_sb.yMax() if above else best_sb.yMin()
		width  = best_sb.getDY()

		return center, farend, width

	def _asw_power_solo(self, asw):
		# Process each power pin
		for it in asw.getITerms():
			# Matching net
			net = it.getNet()

			# Only consider power/ground
			if it.getSigType() not in ['POWER', 'GROUND']:
				continue

			# Orientation, should we connect above or below ?
			orient = asw.getOrient()

			if orient in [ 'R0', 'MY' ]:
				above = False
			elif orient in [ 'R180', 'MX' ]:
				above = True
			else:
				raise RuntimeError('Unknown orientation of analog switch')

			# Bounding box of terminal
			bbox = it.getBBox()

			xl = bbox.xMin()
			xr = bbox.xMax()
			xc = bbox.xCenter()
			xw = bbox.dx()

			y  = bbox.yMin() if above else bbox.yMax()

			# Find PDN stripe
			pdn_center, pdn_farend, pdn_width = self._asw_find_pdn_stripe(net, y, above)

			# Prepare to add special routing
			sw = odb.dbSWire.create(net, "ROUTED")

			# Add via
			via = self.pwr_vg.get4sz_ext(xw, pdn_width, bot_fit='x', top_fit='y')
			odb.createSBoxes(sw, via, [odb.Point(xc, pdn_center)], "STRIPE")

			# Extend the ITerm stripe to PDN
			odb.createSBoxes(sw, via.getBottomLayer(), [odb.Rect(xl, y, xr, pdn_farend)], "STRIPE")

	def _asw_power_pair(self, asw_bot, asw_top):
		# Process each power pin
		for it_bot in asw_bot.getITerms():
			# Matching net
			net = it_bot.getNet()

			# Only consider power/ground
			if it_bot.getSigType() not in ['POWER', 'GROUND']:
				continue

			# Get matching iterm
			it_top = asw_top.findITerm(it_bot.getMTerm().getName())

			# Coordinates
			bbox_bot = it_bot.getBBox()
			bbox_top = it_top.getBBox()

			xl = bbox_bot.xMin()
			xr = bbox_bot.xMax()
			xc = bbox_bot.xCenter()
			xw = bbox_bot.dx()

			yb = bbox_bot.yMin()
			yt = bbox_top.yMax()

			# Find PDN stripe
			pdn_center, pdn_farend, pdn_width = self._asw_find_pdn_stripe(net, yb, True)

			# Prepare to add special routing
			sw = odb.dbSWire.create(net, "ROUTED")

			# Add via
			via = self.pwr_vg.get4sz_ext(xw, pdn_width, bot_fit='x', top_fit='y')
			odb.createSBoxes(sw, via, [odb.Point(xc, pdn_center)], "STRIPE")

			# Create strap
			odb.createSBoxes(sw, via.getBottomLayer(), [odb.Rect(xl, yb, xr, yt)], "STRIPE")


	def asw_power(self):
		# Group the analog switch per x coordinate
		xgrp = {}
		for inst in self.asw:
			xgrp.setdefault(inst.getLocation()[0], set()).add(inst)

		# Try to pair them
		asw_grp = []

		for grp in xgrp.values():
			while len(grp):
				# Pick one
				asw0 = grp.pop()

				# Scan the rest of the group for a potential pair
				for inst in grp:
					# Pair must have opposite orientation
					if inst.getOrient() == asw0.getOrient():
						continue

					# Pair must be close
					dist  = abs(inst.getLocation()[1] - asw0.getLocation()[1])
					limit = asw0.getBBox().getDY() * 3

					if dist < limit:
						asw1 = inst
						break
				else:
					# Nothing found
					asw_grp.append( (asw0, None) )
					continue

				# We found a pair, sort them as (bot, top)
				if asw0.getLocation()[1] > asw1.getLocation()[1]:
					asw_grp.append( (asw1, asw0) )
				else:
					asw_grp.append( (asw0, asw1) )

				# Also remove the match from the set
				grp.remove(asw1)

		# Process each group
		for asw0, asw1 in asw_grp:
			if asw1 is None:
				self._asw_power_solo(asw0)
			else:
				self._asw_power_pair(asw0, asw1)

	def asw_bus(self):
		# Offset
		OFFSET = tt.LayoutDimension(3000).iu

		# Look at all analog switches to find extent
		#  First scan to group per block
		abi  = {}
		nets = set()

		for inst in self.asw:
			# Which block does it belong do
			blk = inst.getName().rsplit('.',1)[0]

			# Record position and and net
			it = inst.findITerm('bus')

			xpos = it.getAvgXY()[1]
			net  = it.getNet()

			bi = abi.setdefault(blk, ([], []))
			bi[0].append(xpos)
			bi[1].append(net.getName())

			nets.add(net.getName())

		# Then for each net
		for net_name in nets:
			# Accumulate all relevant X positions
			xpl = []
			for blk, bi in abi.items():
				if net_name in bi[1]:
					xpl.extend(bi[0])

			# Get actual net, associated bterm and routing infos
			net = self.reader.block.findNet(net_name)

			if False:
				bterm = net.getBTerms()[0]
				bbox  = bterm.getBBox()
				ri = self.route_data[bterm.getName()]

				# Actual IO position
				_, xp_bterm, yp_bterm = bterm.getFirstPinLocation()

			else:
				ckt = [x for x in net.getITerms() if 'ckt' in x.getName()][0]

				ri = self.route_data[net.getName()]
				bbox = ckt.getBBox()
				_, xp_bterm, yp_bterm = ckt.getAvgXY()

			# Side of the IO
			w = self.ndr.getLayerRule(self.layer_bot).getWidth()
			mid = self.reader.block.getDieArea().dx() // 2

			if xp_bterm > mid:
				# IO goes right side
				xp_start = min(xpl) - OFFSET
				xp_pad   = bbox.xMin() - (w//2)

			else:
				# IO goes left side
				xp_start = max(xpl) + OFFSET
				xp_pad   = bbox.xMax() + (w//2)

			# Convert to internal unit
			ri = [ tt.LayoutDimension(x).iu for x in ri ]

			# Prepare for routing
			net.setNonDefaultRule(self.ndr)

			wire = odb.dbWire.create(net)

			encoder = odb.dbWireEncoder()
			encoder.begin(wire)

			# Create the 'bus' part
			encoder.newPath(self.layer_bot, 'FIXED', self.ndr.getLayerRule(self.layer_bot))

			encoder.addPoint(xp_start, ri[0])
			encoder.addPoint(ri[1],    ri[0])
			encoder.addPoint(ri[1],    yp_bterm)
			encoder.addPoint(xp_pad,   yp_bterm)

			encoder.newPath(self.layer_bot, 'FIXED')
			encoder.addPoint(xp_pad,   yp_bterm)
			encoder.addPoint(xp_bterm, yp_bterm)

			# Create all the stubs
			for inst in self.asw:
				# Connected to this net ?
				it = inst.findITerm('bus')

				if it.getNet().getName() != net_name:
					continue

				# Position of terminal
				_, xp_iterm, yp_iterm = it.getAvgXY()

				# Offset Shift
				if yp_iterm > ri[0]:
					xp_int = xp_iterm + OFFSET
					yp_int = it.getBBox().yMin() + (w // 2)
				else:
					xp_int = xp_iterm - OFFSET
					yp_int = it.getBBox().yMax() - (w // 2)

				# Create stub
				encoder.newPath(self.layer_top, 'FIXED', self.ndr.getLayerRule(self.layer_top))

				encoder.addPoint(xp_iterm, yp_int)
				encoder.addPoint(xp_int,   yp_int)
				encoder.addPoint(xp_int,   ri[0])
				encoder.addVia(self.via)

			# Done routing
			encoder.end()

	def asw_mod(self):
		# Scan all switches
		for inst_asw in self.asw:
			# Get the module connection
			it_asw = inst_asw.findITerm('mod')

			# Get net
			net = it_asw.getNet()
			net.setNonDefaultRule(self.ndr)

			# Get the two iterms to connect
			its = net.getITerms()
			if len(its) != 2:
				raise RuntimeError('Too many module connections')

			it_mod = its[0] if (its[1].this == it_asw.this) else its[1]

			_, x0, y0 = it_mod.getAvgXY()
			_, x1, y1 = it_asw.getAvgXY()

			# Prepare to route
			wire = odb.dbWire.create(net)

			encoder = odb.dbWireEncoder()
			encoder.begin(wire)

			# Workaround for narrow pads
			# Remove in TT7 when analog template is updated ...
			w = self.ndr.getLayerRule(self.layer_top).getWidth()

			encoder.newPath(self.layer_top, 'FIXED')
			encoder.addPoint(x0, y0)
			y0 = (it_mod.getBBox().yMin() - (w//2)) if (y0 > y1) else (it_mod.getBBox().yMax() + (w//2))
			encoder.addPoint(x0, y0)

			# Path
			encoder.newPath(self.layer_top, 'FIXED', self.ndr.getLayerRule(self.layer_top))
			encoder.addPoint(x0, y0)

			if x0 != x1:
				ym = (y0 + y1) // 2
				encoder.addPoint(x0, ym)
				encoder.addPoint(x1, ym)

			encoder.addPoint(x1, y1)

			# Done routing
			encoder.end()

	def _asw_obs_hor(self, lst, y_min, y_max):
		# Init
		x_min = None
		x_max = None

		# Scan each
		for net_name in lst:
			net = self.reader.block.findNet(net_name)
			for it in net.getITerms():
				_, x, y = it.getAvgXY()

				x_min = min(x_min, x) if (x_min is not None) else x
				x_max = max(x_max, x) if (x_max is not None) else x
				y_min = min(y_min, y)
				y_max = max(y_max, y)

		if (x_min is None) or (x_max is None):
			return

		# Create obstructions
		odb.dbObstruction_create(self.reader.block,
			self.layer_bot,
			x_min, y_min,
			x_max, y_max,
		)

		odb.dbObstruction_create(self.reader.block,
			self.layer_top,
			x_min, y_min,
			x_max, y_max,
		)

	def _asw_obs_ver(self, lst):
		# Init
		x_min = None
		x_max = None
		y_min = None
		y_max = None

		# Scan each
		for net_name in lst:
			net = self.reader.block.findNet(net_name)
			bt = net.get1stBTerm()
			_, x, y = bt.getFirstPinLocation()

			x_min = min(x_min, x) if (x_min is not None) else x
			x_max = max(x_max, x) if (x_max is not None) else x
			y_min = min(y_min, y) if (y_min is not None) else y
			y_max = max(y_max, y) if (y_max is not None) else y

			yr = self.route_data[net_name][0]
			y_min = min(y_min, yr)
			y_max = max(y_max, yr)

		# Create obstruction
		odb.dbObstruction_create(self.reader.block,
			self.layer_bot,
			x_min, y_min,
			x_max, y_max,
		)

	def asw_obs(self):
		# Scan and groups the bus
		grp = []

		for net_name, net_rd in self.route_data.items():
			# Scan existing groups
			for i, (g_min, g_max, g_lst) in enumerate(grp):
				# Close ?
				if (abs(g_min - net_rd[0]) < 20000) or (abs(g_max - net_rd[0]) < 20000):
					g_lst.append(net_name)
					grp[i] = (
						min([g_min, net_rd[0]]),
						max([g_max, net_rd[0]]),
						g_lst
					)
					break

			else:
				# New group
				grp.append( (net_rd[0], net_rd[0], [net_name]) )

		# For each group, create horizontal and vertical obstructions
		for g_min, g_max, g_lst in grp:
			self._asw_obs_hor(g_lst, g_min, g_max)
			self._asw_obs_ver(g_lst)

	def asw_ena(self):
		# Scan all the user modules
		for um_inst in self.reader.instances:
			# Is this a user module ?
			if not um_inst.getName().endswith('.tt_um_I'):
				continue

			# Find matching mux
			ena_net = um_inst.findITerm('ena').getNet()

			mux_inst = None
			asw_insts = []

			for it in ena_net.getITerms():
				# Get info about attached block
				inst = it.getInst()
				master_name = inst.getMaster().getName()

				# Keep mux and analog switch
				if inst.getMaster().getName() == 'tt_mux':
					mux_inst = inst
					mux_it = it
				elif inst.getMaster().getName().startswith('tt_asw'):
					asw_insts.append(inst)

			if (mux_inst is None) or len(asw_insts) == 0:
				continue

			# X position of the mux (same as module)
			_, xp0, _ = mux_it.getAvgXY()

			# X position on the side of module away from PG
			if um_inst.getOrient() in ['R180', 'MY']:
				xp1 = um_inst.getBBox().xMin() - self.tti.layout.glb.margin.x // 2
			else:
				xp1 = um_inst.getBBox().xMax() + self.tti.layout.glb.margin.x // 2

			# Y postition between module and mux
			yl0 = sorted([
				mux_inst.getBBox().yMin(),
				mux_inst.getBBox().yMax(),
				um_inst.getBBox().yMin(),
				um_inst.getBBox().yMax(),
			])[1:3]

			yl0 = [ yl0[0], sum(yl0) // 2, yl0[1] ]

			# Y position between module and analog switch
			yp1 = sum(sorted([
				asw_insts[0].getBBox().yMin(),
				asw_insts[0].getBBox().yMax(),
				um_inst.getBBox().yMin(),
				um_inst.getBBox().yMax(),
			])[1:3]) // 2

			# X,Y positions of ASW terminal
			xl2 = []
			for inst in asw_insts:
				_, x, y = inst.findITerm('ctrl').getAvgXY()
				xl2.append(x)
				yp2 = y

			# Find which X position is "farthest" from xp1
			if xp1 > max(xl2):
				xp2 = min(xl2)
			else:
				xp2 = max(xl2)

			# Create routing
			wire = odb.dbWire.create(ena_net)

			encoder = odb.dbWireEncoder()
			encoder.begin(wire)

			encoder.newPath(self.layer_top, 'FIXED')
			encoder.addPoint(xp0, yl0[0])
			encoder.addPoint(xp0, yl0[2])

			encoder.newPath(self.layer_top, 'FIXED')
			encoder.addPoint(xp0, yl0[1])
			encoder.addPoint(xp1, yl0[1])
			encoder.addPoint(xp1, yp1)
			encoder.addTechVia(self.via_sig)
			encoder.addPoint(xp2, yp1)

			for x in xl2:
				encoder.newPath(self.layer_bot, 'FIXED')
				encoder.addPoint(x, yp1)
				encoder.addPoint(x, yp2)

			encoder.end()

	def run(self):
		self.asw_power()
		self.asw_bus()
		self.asw_mod()
		##self.asw_obs()
		self.asw_ena()


class PadRingPowerStrapper:

	def __init__(self, reader):
		# Save vars
		self.reader = reader

		# Find useful data
		self.tech = tech = reader.db.getTech()

		self.layer = tech.findLayer('TopMetal1')
		self.viagen = ViaGenerator(reader, 'viaTop1Array')


	def find_padring_obstruction(self):
		# sg13cmos5l_IOPadVdd instances have TopMetal1 in the way, don't create
		# straps if there is an instance there
		blacklist = { 'sg13cmos5l_IOPadVdd' }

		bad_insts = [
			inst for inst in self.reader.block.getInsts()
				if (inst.getMaster().getName() in blacklist) and
					(inst.getOrient() in {'R90', 'MXR90'})
		]

		self.obs_left  = []
		self.obs_right = []

		for inst in bad_insts:
			bbox = inst.getBBox()
			if inst.getOrient() == "R90":
				self.obs_right.append( (bbox.yMin(), bbox.yMax()) )
			else:
				self.obs_left.append( (bbox.yMin(), bbox.yMax()) )


	def find_padring_fill(self):
		# Find a filler instance on right side and left side
		self.fill_left  = None
		self.fill_right = None

		for inst in self.reader.block.getInsts():
			if not inst.getMaster().getName().startswith('sg13cmos5l_Filler'):
				continue

			if inst.getOrient() == "R90":
				self.fill_right = inst
			elif inst.getOrient() == "MXR90":
				self.fill_left = inst

			if (self.fill_right is not None) and (self.fill_left is not None):
				break

		else:
			raise RuntimeError("Unable to find fillers on both sides of the padring")


	def find_padring_rails(self, net):
		# For each find the limits
		rails = []

		for inst in [self.fill_left, self.fill_right]:
			# Find the matching ITerm on the net
			for it in net.getITerms():
				if it.getInst().this == inst.this:
					break
			else:
				raise RuntimeError("Trying to connect net that's not on the pad ring")

			# Find
			rects = [ r for (l,r) in it.getGeometries() if l.getName() == "Metal4" ]
			if len(rects) != 1:
				raise RuntimeError("More than one rectangle found")

			rails.append( ( rects[0].xMin(), rects[0].xMax() ) )

		return rails


	def connect_net(self, net):
		# Get the rails
		rail_left, rail_right = self.find_padring_rails(net)

		# Create new SWire
		sw_new = odb.dbSWire.create(net, "ROUTED")

		# Scan all stripes
		for sw in net.getSWires():
			for w in sw.getWires():
				# Only stripes
				if w.isVia():
					continue

				if w.getWireShapeType() != 'STRIPE':
					continue

				# Process each rails
				y = (w.yMin() + w.yMax()) // 2
				h = w.getDY()

				data = [
					( rail_left[0], w.xMin(),  rail_left[0],  rail_left[1],  self.obs_left  ),
					( w.xMax(), rail_right[1], rail_right[0], rail_right[1], self.obs_right ),
				]

				for x0, x1, xv0, xv1, obs in data:
					# Check for obstructions
					if any([ (obs_y1 >= w.yMin()) and (obs_y0 <= w.yMax()) for obs_y0, obs_y1 in obs]):
						continue

					# Add via
					via = self.viagen.get4sz_ext(xv1 - xv0, h, bot_fit='xy', top_fit='y')
					odb.createSBoxes(sw_new, via, [odb.Point((xv0 + xv1) // 2, y)], "STRIPE")

					# Add stripe
					stripe_rect = odb.Rect(x0, w.yMin(), x1, w.yMax())
					odb.createSBoxes(sw_new, self.layer, [stripe_rect], "STRIPE")


	def run(self):
		# Find filler cells to use as reference for rail position
		self.find_padring_fill()

		# Find zones to avoid
		self.find_padring_obstruction()

		# Process power nets
		pwr_nets = [
			net for net in self.reader.block.getNets()
				if net.getSigType() in ['POWER', 'GROUND']
		]

		for net in pwr_nets:
			if net.getName() not in ['vgnd', 'vdpwr']:
				continue
			self.connect_net(net)


@click.command()
@click_odb
def route(
	reader,
):

	# Load TinyTapeout
	tti = tt.TinyTapeout(modules=False)

	# Create router
	r = Router(reader, tti)
	r.route_vspine()
	r.create_spine_obs()
	r.create_macro_obs()
	#r.route_k01_global()
	#r.route_k01_gpio()
	#r.create_k01_obs()
	r.route_pad()
	r.route_um_tieoffs()
	r.route_um_signals()

	# Create the module power straps
	p = ModulePowerStrapper(reader, tti)
	p.run()

	# Create the ring power straps
	p = RingPowerStrapper(reader)
	p.run()

	# Create the padring power straps
	p = PadRingPowerStrapper(reader)
	p.run()

	# Analog router
	a = AnalogRouter(reader, tti)
	a.run()

	# Remove all BTerms that have no connections
	bt_to_del = []

	for bt in reader.block.getBTerms():
		n = bt.getNet()
		if (n.getITermCount() == 0) and (n.getBTermCount() == 1):
			bt_to_del.append(bt)

	for bt in bt_to_del:
		odb.dbBTerm.destroy(bt)


if __name__ == "__main__":
	route()
