TinyTapeout/tt-multiplexer/cfg/ihp-sg13cmos5l-18.yaml

pdk:
  name: ihp-sg13cmos5l
  tech: ihp-sg13cmos5l
  die:
    width:  3600000
    height: 5000000
    margin:
      left:   445000
      right:  445000
      top:    460000
      bottom: 460000
  site:
    width:  480
    height: 3780
  pwrgate:
    vdd:
      name: 'tt_pg_1v5'
      width: 9600
      variants: ['ll', 'hp']
    vaa:
      name: 'tt_pg_3v3'
      width: 12480
  analog:
    switch:
      name: 'tt_asw_3v3'
      width: 22560
      height: 28500
    pad:
      width: 3000
  tracks:
    Metal1:
      x:
        offset: 0
        pitch:  480
        width:  160
      y:
        offset: 0
        pitch:  420
        width:  160
    Metal2:
      x:
        offset: 0
        pitch:  480
        width:  200
      y:
        offset: 0
        pitch:  420
        width:  200
    Metal3:
      x:
        offset: 0
        pitch:  480
        width:  200
      y:
        offset: 0
        pitch:  420
        width:  200
    Metal4:
      x:
        offset: 0
        pitch:  480
        width:  200
      y:
        offset: 0
        pitch:  420
        width:  200
    TopMetal1:
      x:
        offset: 1700
        pitch:  3400
        width:  1600
      y:
        offset: 1700
        pitch:  3400
        width:  1600
tt:
  grid:     # In number of blocks
    x: 12   # Must be divisible by 4
    y: 20   # Must be EVEN
  block:
    w: -1
    h: -1
  margin:   # In 'sites'
    x: 6
    y: 1
  uio:
    ae: 16
    au:  8
    i:  10
    o:   8
    io:  8
  spine:
    vlayer: 'Metal4'
    hlayer: 'Metal3'
  analog:
    - mux_id: [ 2 ]
      pins:
        0: 1004000
        1: 1276000
        2: 1548000
        3: 1820000
        4: 2636000
        5: 2908000
        6: 3180000
        7: 3452000
    - mux_id: [ 5 ]
      pins:
        8: 3452000
        9: 3180000
        10: 2908000
        11: 2636000
    - mux_id: [ 8 ]
      pins:
        12: 1820000
        13: 1548000
        14: 1276000
        15: 1004000
  huge_modules:
    mux_id: [ 10 ] # 10, 7, 15, 13
  logo:
    tt_logo_top:
      width: 50000
      height: 50000
      orient: 'N'
      x:
        align: 'center'
        anchor: 'spine.center'
        offset: 0
      y:
        align: 'top'
        anchor: 'top_level.top'
        offset: -3780
    tt_logo_bottom:
      width: 50000
      height: 50000
      orient: 'N'
      x:
        align: 'center'
        anchor: 'spine.center'
        offset: 0
      y:
        align: 'bottom'
        anchor: 'top_level.bottom'
        offset: 3780
    tt_logo_corner:
      width: 100000
      height: 100000
      orient: 'N'
      x:
        offset: 50000
      y:
        offset: 50000
