TinyTapeout/tt-multiplexer/ol2/tt_top/build.py

#!/usr/bin/env python3

#
# OpenLane2 build script to harden the tt_top macro inside
# the openframe_project_wrapper
#
# Copyright (c) 2023 Sylvain Munaut <tnt@246tNt.com>
# SPDX-License-Identifier: Apache-2.0
#

import argparse
import json
import math
import os
import pathlib
import shutil
import sys

from os.path import abspath
from typing import List, Tuple, Type

from librelane.common import Path
from librelane.flows.misc import OpenInKLayout
from librelane.flows.sequential import SequentialFlow
from librelane.state import DesignFormat, State
from librelane.steps.klayout import KLayoutStep
from librelane.steps.odb import OdbpyStep
from librelane.steps.openroad import OpenROADStep
from librelane.steps.step import ViewsUpdate, MetricsUpdate
from librelane.steps import (
	Step,
	Yosys,
	OpenROAD,
	Magic,
	Misc,
	KLayout,
	Odb,
	Netgen,
	Checker,
)

sys.path.append('../../py')
import tt


@Step.factory.register()
class CustomPower(OdbpyStep):

	id = "TT.Top.CustomPower"
	name = "Custom Power connections for TT Top Level"

	def get_script_path(self):
		return os.path.join(
			os.path.dirname(__file__),
			"odb_power.py"
		)


@Step.factory.register()
class CustomRoute(OdbpyStep):

	id = "TT.Top.CustomRoute"
	name = "Custom Pre-Routing for TT Top Level"

	def get_script_path(self):
		return os.path.join(
			os.path.dirname(__file__),
			"odb_route.py"
		)


@Step.factory.register()
class PadRing(OpenROADStep):

	id = "TT.Top.PadRing"
	name = "Creates Pad Ring"

	def get_script_path(self):
		return os.path.join(
			os.path.dirname(__file__),
			"padring.tcl"
		)

@Step.factory.register()
class PlaceCktAna(OdbpyStep):

	id = "TT.Top.PlaceCktAna"
	name = "Place analog pads contacts to core"

	def get_script_path(self):
		return os.path.join(
			os.path.dirname(__file__),
			"odb_place_ckt_ana.py"
		)


@Step.factory.register()
class FixupBTerms(OdbpyStep):

	id = "TT.Top.FixupBTerms"
	name = "Custom Fixups for TT Top Level"

	def get_script_path(self):
		return os.path.join(
			os.path.dirname(__file__),
			"odb_prune_bterms.py"
		)

@Step.factory.register()
class IHPExtractSpice(Step):

	id = "TT.IHP.ExtractSpice"
	name = "Extracts SPICE netlist from GDS using metal only"

	inputs = [DesignFormat.GDS]
	outputs = [DesignFormat.SPICE]

	def run(self, state_in: State, **kwargs) -> Tuple[ViewsUpdate, MetricsUpdate]:
		views_updates: ViewsUpdate = {}

		input_gds = state_in[DesignFormat.GDS]
		output_spice = os.path.join(
			self.step_dir,
			f"{self.config['DESIGN_NAME']}.{DesignFormat.SPICE.extension}"
		)

		script = os.path.join(
			os.path.dirname(__file__),
			"../../py/ihp_extract_spice.py"
		)

		self.run_subprocess(
			[
				script,
				abspath(input_gds),
				abspath(output_spice),
			],
		)

		views_updates[DesignFormat.SPICE] = Path(output_spice)

		return views_updates, {}


@Step.factory.register()
class FixupExtractedNetlist(Step):

	id = "TT.Top.FixupExtractedNetlist"
	name = "Fix netlist port for LVS"

	inputs = [DesignFormat.SPICE]
	outputs = [DesignFormat.SPICE]

	def run(self, state_in: State, **kwargs) -> Tuple[ViewsUpdate, MetricsUpdate]:
		views_updates: ViewsUpdate = {}

		input_spice = state_in[DesignFormat.SPICE]
		output_spice = os.path.join(
			self.step_dir,
			f"{self.config['DESIGN_NAME']}.{DesignFormat.SPICE.extension}"
		)

		script = os.path.join(
			os.path.dirname(__file__),
			"../../py/ihp_fixup_netlist.py"
		)

		self.run_subprocess(
			[
				script,
				abspath(input_spice),
				abspath(output_spice),
			],
		)

		views_updates[DesignFormat.SPICE] = Path(output_spice)

		return views_updates, {}


class TopFlow(SequentialFlow):

	Steps: List[Type[Step]] = [
		Yosys.JsonHeader,
		Yosys.Synthesis,
		Checker.YosysUnmappedCells,
		Checker.YosysSynthChecks,
		OpenROAD.Floorplan,
		CustomPower,
		PadRing,
		PlaceCktAna,
		FixupBTerms,
		Odb.ManualMacroPlacement,
		OpenROAD.GeneratePDN,
		OpenROAD.GlobalPlacement,
		OpenROAD.DetailedPlacement,
		CustomRoute,
		OpenROAD.GlobalRouting,
		OpenROAD.DetailedRouting,
		Checker.TrDRC,
		Odb.ReportDisconnectedPins,
		Checker.DisconnectedPins,
		Odb.ReportWireLength,
		Checker.WireLength,
		OpenROAD.RCX,
		OpenROAD.STAPostPNR,
		OpenROAD.IRDropReport,
		Magic.StreamOut,
		KLayout.StreamOut,
		KLayout.XOR,
		Checker.XOR,

		IHPExtractSpice,
		Netgen.LVS,
		Checker.LVS,

		Magic.SpiceExtraction,
		Checker.IllegalOverlap,
		FixupExtractedNetlist,
		Netgen.LVS,
		Checker.LVS,

		KLayout.DRC,
		Checker.KLayoutDRC,

#		Magic.DRC,
#		Checker.MagicDRC,

		KLayout.SealRing,
	]


def copy_macros(cfg):
	# Copy-List
	CPL = [
		( 'v',   'src', 'verilog' ),
		( 'lef', 'lef', 'lef' ),
		( 'gds', 'gds', 'gds' ),
	]

	# Source/Destination bases
	src_base = pathlib.Path.cwd().parents[1]
	dst_base = pathlib.Path.cwd()

	# Pre-create destinations
	for ext, src_subdir, dst_subdir in CPL:
		(dst_base / dst_subdir).mkdir(exist_ok=True)

	# Scan each type
	for mtype in [ 'blocks', 'logo', 'pg', 'asw' ]:
		# Build path
		p = src_base / mtype / cfg.pdk.tech

		# Is there anything ?
		if not p.is_dir():
			continue

		# Iterate content
		for src_path in p.iterdir():
			# Only parse directory
			if not src_path.is_dir():
				continue

			# Process copy list
			for ext, src_subdir, dst_subdir in CPL:
				src_file = src_path / src_subdir / f'{src_path.name}.{ext}'
				dst_path = dst_base / dst_subdir
				if src_file.is_file():
					shutil.copy(src_file, dst_path)


if __name__ == '__main__':
	# Argument processing
	parser = argparse.ArgumentParser(formatter_class=argparse.ArgumentDefaultsHelpFormatter)
	parser.add_argument("--open-in-klayout", action="store_true", help="Open last run in KLayout")
	parser.add_argument("--skip-xor-checks", action="store_true", help="Skips XOR checks")

	args = parser.parse_args()
	config = vars(args)

	if config['skip_xor_checks']:
		TopFlow.Steps.remove(KLayout.XOR)
		TopFlow.Steps.remove(Checker.XOR)

	# Get PDK root out of environment
	PDK_ROOT = os.getenv('PDK_ROOT')

	# Load TinyTapeout
	tti = tt.TinyTapeout()

	# Copy local macros
	copy_macros(tti.cfg)

	# Generate macros
	macros = { }
	user_modules = []
	disc_modules = []

	for m in tti.die.get_sub_macros():
		if m.mod_name not in macros:
			macros[m.mod_name] = {
				'gds': [ f'dir::gds/{m.mod_name:s}.gds', ],
				'lef': [ f'dir::lef/{m.mod_name:s}.lef', ],
				'instances': { }
			}
			if m.mod_name.startswith('tt_um_'):
				user_modules.append(m.mod_name)
			else:
				md = {
					'nl': f'dir::verilog/{m.mod_name:s}.v',
				}
				if os.path.isfile(f'spef/{m.mod_name:s}.nom.spef'):
					md['spef'] = {
#						"min_*": [ f'dir::spef/{m.mod_name:s}.min.spef' ],
						"nom_*": [ f'dir::spef/{m.mod_name:s}.nom.spef' ],
#						"max_*": [ f'dir::spef/{m.mod_name:s}.max.spef' ],
					}
				macros[m.mod_name].update(md)
			if m.is_logo:
				disc_modules.append(m.mod_name)

		macros[m.mod_name]['instances'][m.inst_name] = {
			"location": [ m.pos.x.um, m.pos.y.um ],
			"orientation": m.orient,
		}

	macros['tt_ckt_ana'] = {
		'gds': [ f'dir::gds/tt_ckt_ana.gds', ],
		'lef': [ f'dir::lef/tt_ckt_ana.lef', ],
		'nl': f'dir::verilog/tt_ckt_ana.v',
		'instances': { }
	}
	disc_modules.append('tt_ckt_ana')

	# Generate dummy for all user modules
	mod_tpl = open('tt_um_tpl.v', 'r').read()
	open('verilog/tt_um_all.v', 'w').write('\n'.join([
		mod_tpl.format(mod_name=m)
			for m in user_modules
	]))

	# Custom config
	flow_cfg = {
		# Main design properties
		"DESIGN_NAME"    : "tt_ihp_wrapper",
		"DESIGN_IS_CORE" : False,

		# Sources
		"VERILOG_FILES": [
			"dir::tt_ihp_wrapper.v",
			"dir::../../rtl/tt_top.v",
			"dir::../../rtl/tt_ihp_gpio.v",
			"dir::../../rtl/tt_user_module.v",
		],

		"VERILOG_POWER_DEFINE": "USE_POWER_PINS",

		# Macros
		"MACROS": macros,
		"EXTRA_VERILOG_MODELS": [
			"dir::verilog/tt_um_all.v",
		],
		"EXTRA_LEFS": [
			"dir::lef/bondpad_70x70.lef",
		],
		"EXTRA_GDS_FILES": [
			"dir::gds/bondpad_70x70.gds",
		],

		# Constraints
		"SIGNOFF_SDC_FILE" : "dir::signoff.sdc",

		# Synthesis
		"SYNTH_ELABORATE_ONLY"      : True,
		"SYNTH_USE_PG_PINS_DEFINES" : "USE_POWER_PINS",

		"SYNTH_EXCLUSION_CELL_LIST" : "dir::no_synth_cells.txt",
		"PNR_EXCLUSION_CELL_LIST"   : "dir::no_drc_cells.txt",
		"DRC_EXCLUDE_CELL_LIST"     : "dir::no_drc_cells.txt",

		"QUIT_ON_SYNTH_CHECKS"      : False,

		# Floorplanning
		"FP_SIZING" : "absolute",

		# PDN
		"VDD_NETS": [ "vdpwr", "vapwr" ],
		"GND_NETS": [ "vgnd",  "vgnd"  ],

		"PDN_CFG": "dir::pdn.tcl",

		"PDN_CONNECT_MACROS_TO_GRID"    : False,
		"PDN_ENABLE_GLOBAL_CONNECTIONS" : False,

		"FP_PDN_CORE_RING"          : True,
		"FP_PDN_CORE_RING_VWIDTH"   : 30,
		"FP_PDN_CORE_RING_HWIDTH"   : 30,
		"FP_PDN_CORE_RING_VOFFSET"  :  0,
		"FP_PDN_CORE_RING_HOFFSET"  :  0,
		"FP_PDN_CORE_RING_VSPACING" :  3.0,
		"FP_PDN_CORE_RING_HSPACING" :  3.0,

		# Routing
		"GRT_ALLOW_CONGESTION"  : True,
		"GRT_REPAIR_ANTENNAS"   : False,
		"DRT_ANTENNA_REPAIR_ITERS" : 0,
		"RT_MAX_LAYER"          : "TopMetal1",

		# Magic stream
		"MAGIC_ZEROIZE_ORIGIN" : False,

		# DRC
		"MAGIC_DRC_USE_GDS": True,
		"KLAYOUT_DRC_RUNSET": "pdk_dir::libs.tech/klayout/tech/drc/ihp-sg13cmos5l.drc",

		# LVS
		"MAGIC_DEF_LABELS" : False,
		"MAGIC_EXT_SHORT_RESISTOR" : True, # Fixes LVS failures when more than two pins are connected to the same net
		"IGNORE_DISCONNECTED_MODULES": disc_modules,
	}

	# Pad config
	flow_cfg["PAD_SOUTH"] = [ f"gpio\\[{i}\\].gpio_I.genblk1.pad_I" for i in range( 0,16) ]
	flow_cfg["PAD_EAST"]  = [ f"gpio\\[{i}\\].gpio_I.genblk1.pad_I" for i in range(16,32) ]
	flow_cfg["PAD_NORTH"] = [ f"gpio\\[{i}\\].gpio_I.genblk1.pad_I" for i in reversed(range(32,48)) ]
	flow_cfg["PAD_WEST"]  = [ f"gpio\\[{i}\\].gpio_I.genblk1.pad_I" for i in reversed(range(48,64)) ]

	# Update die area based on data from config
	die_w = tti.cfg.pdk.die.width.um
	die_h = tti.cfg.pdk.die.height.um

	core_x0 = 421.0
	core_y0 = 425.0
	core_x1 = die_w - 421.0
	core_y1 = die_h - 425.0

	flow_cfg.update({
		"DIE_AREA"  : [   0.00,     0.00,   die_w,   die_h ],
		"CORE_AREA" : [ core_x0, core_y0, core_x1, core_y1 ],
	})

	# Update PDN config
	pdn_width   =  12.0
	pdn_spacing =   3.0
	pdn_pitch   = (tti.layout.glb.branch.pitch // 5).um
	pdn_offset  = (
		tti.layout.glb.top.pos_y +
		tti.layout.glb.branch.pitch // 10 -
		tti.layout.glb.margin.y // 2
	).um
	pdn_offset -= (pdn_spacing + pdn_width)

	sh = tti.cfg.pdk.site.height.um
	if 'CORE_AREA' in flow_cfg:
		pdn_offset -= math.ceil(flow_cfg['CORE_AREA'][1] / sh) * sh
	else:
		pdn_offset -= sh * flow_cfg.get('BOTTOM_MARGIN_MULT', 4)

	while pdn_offset > (pdn_pitch * 1.1):
		pdn_offset -= pdn_pitch

	def pdn_align(x):
		grid = 0.005
		return round(x / grid) * grid

	flow_cfg.update({
		"FP_PDN_HWIDTH"  : pdn_align(pdn_width),
		"FP_PDN_HSPACING": pdn_align(pdn_spacing),
		"FP_PDN_HPITCH"  : pdn_align(pdn_pitch),
		"FP_PDN_HOFFSET" : pdn_align(pdn_offset),
	})

	# Run flow
	flow_kls = OpenInKLayout if args.open_in_klayout else TopFlow
	flow = flow_kls(
		flow_cfg,
		design_dir = ".",
		pdk_root   = PDK_ROOT,
		pdk        = tti.cfg.pdk.name,
	)

	flow.start(last_run = args.open_in_klayout)
