TinyTapeout/tt-multiplexer/asw/ihp-sg13cmos5l/tt_ckt_ana/src/tt_ckt_ana.v

/*
 * tt_ckt_ana.v
 *
 * Blackbox for the analog IO contact
 *
 * Copyright (c) 2026 Sylvain Munaut <tnt@246tNt.com>
 * SPDX-License-Identifier: Apache-2.0
 */

(* blackbox *)
module tt_ckt_ana (
    inout wire pad,
    inout wire analog
);

	assign pad = analog;
	assign analog = pad;

endmodule
