TinyTapeout/tt-multiplexer/pg/ihp-sg13cmos5l/tt_pg_3v3_2/src/tt_pg_3v3_2.v

/*
 * tt_pg_3v3_2.v
 *
 * Blackbox for the 3v3 power gate
 *
 * Copyright (c) 2026 Sylvain Munaut <tnt@246tNt.com>
 * SPDX-License-Identifier: Apache-2.0
 */

(* blackbox *)
module tt_pg_3v3_2 (
`ifdef USE_POWER_PINS
	input  wire VGND,
	input  wire VDPWR,
	input  wire VAPWR,
	output wire GAPWR,
`endif
	input  wire ctrl
);

`ifdef USE_POWER_PINS
	assign GAPWR = ctrl ? VAPWR : 1'bz;
`endif

endmodule
