TinyTapeout/tt-multiplexer/ol2/tt_top/tt_um_tpl.v

/*
 * tt_um_tpl.v
 *
 * Dummy user module template used as a STA standin
 *
 * Copyright (c) 2023 Sylvain Munaut <tnt@246tNt.com>
 * SPDX-License-Identifier: Apache-2.0
 */

`default_nettype none

module {mod_name} (
	input  wire VGND,
	input  wire VDPWR,
	input  wire VAPWR,
	inout  wire [7:0] ua,
	input  wire [7:0] ui_in,
	output wire [7:0] uo_out,
	input  wire [7:0] uio_in,
	output wire [7:0] uio_out,
	output wire [7:0] uio_oe,
	input  wire       ena,
	input  wire       clk,
	input  wire       rst_n
);

	gf180mcu_fd_sc_mcu7t5v0__buf_2 buf_in_ui_in_0 (
		.VSS  (VGND),
		.VNW  (VGND),
		.VPW  (VDPWR),
		.VDD  (VDPWR),
		.I    (ui_in[0]),
		.Z    ()
	);

	gf180mcu_fd_sc_mcu7t5v0__buf_2 buf_in_ui_in_1 (
		.VSS  (VGND),
		.VNW  (VGND),
		.VPW  (VDPWR),
		.VDD  (VDPWR),
		.I    (ui_in[1]),
		.Z    ()
	);

	gf180mcu_fd_sc_mcu7t5v0__buf_2 buf_in_ui_in_2 (
		.VSS  (VGND),
		.VNW  (VGND),
		.VPW  (VDPWR),
		.VDD  (VDPWR),
		.I    (ui_in[2]),
		.Z    ()
	);

	gf180mcu_fd_sc_mcu7t5v0__buf_2 buf_in_ui_in_3 (
		.VSS  (VGND),
		.VNW  (VGND),
		.VPW  (VDPWR),
		.VDD  (VDPWR),
		.I    (ui_in[3]),
		.Z    ()
	);

	gf180mcu_fd_sc_mcu7t5v0__buf_2 buf_in_ui_in_4 (
		.VSS  (VGND),
		.VNW  (VGND),
		.VPW  (VDPWR),
		.VDD  (VDPWR),
		.I    (ui_in[4]),
		.Z    ()
	);

	gf180mcu_fd_sc_mcu7t5v0__buf_2 buf_in_ui_in_5 (
		.VSS  (VGND),
		.VNW  (VGND),
		.VPW  (VDPWR),
		.VDD  (VDPWR),
		.I    (ui_in[5]),
		.Z    ()
	);

	gf180mcu_fd_sc_mcu7t5v0__buf_2 buf_in_ui_in_6 (
		.VSS  (VGND),
		.VNW  (VGND),
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
		.VSS  (VGND),
		.VNW  (VGND),
		.VPW  (VDPWR),
		.VDD  (VDPWR),
		.I    (),
		.Z    (uio_oe[6])
	);

	gf180mcu_fd_sc_mcu7t5v0__buf_2 buf_out_uio_oe_7 (
		.VSS  (VGND),
		.VNW  (VGND),
		.VPW  (VDPWR),
		.VDD  (VDPWR),
		.I    (),
		.Z    (uio_oe[7])
	);

endmodule // {mod_name}
