TinyTapeout/tt-multiplexer/rtl/prim_ihp-sg13cmos5l/tt_prim_zbuf.v

/*
 * tt_prim_zbuf.v
 *
 * TT Primitive
 * Zeroing buffer (i.e. AND gate ...)
 *
 * Copyright (c) 2026 Sylvain Munaut <tnt@246tNt.com>
 * SPDX-License-Identifier: Apache-2.0
 */

`default_nettype none

module tt_prim_zbuf #(
	parameter integer HIGH_DRIVE = 0
)(
	input  wire a,
	input  wire e,
	output wire z
);

	generate
		if (HIGH_DRIVE) begin
			wire l;

			sg13cmos5l_and2_2 cell0_I (
				.A (a),
				.B (e),
				.X (l)
			);

			sg13cmos5l_buf_8 cell1_I (
				.A (l),
				.X (z)
			);

		end else begin
			sg13cmos5l_and2_2 cell0_I (
				.A (a),
				.B (e),
				.X (z)
			);
		end
	endgenerate

endmodule // tt_prim_zbuf
