TinyTapeout/tt-multiplexer/(commit log)

2026-09-16 [gf] [HACK] ol2/tt_mux: Fix antenna
    [build.py]
2026-10-20 [ihp] pg: Import all the 1v5 power gates for ihp-sg13cmos5l
2026-10-29 [ihp] pg: Import the 3v3 power gate for ihp-sg13cmos5l
2026-10-29 [ihp] asw: Import the analog switch & contact for SG13CMOS5L
